Anubhav-Anand-7/Peltier-based-Liquid-Cooling-System-for-Temperature-Calibration/Photos & Videos_479_LR2C2/Image01_479_LR2C2.jpg

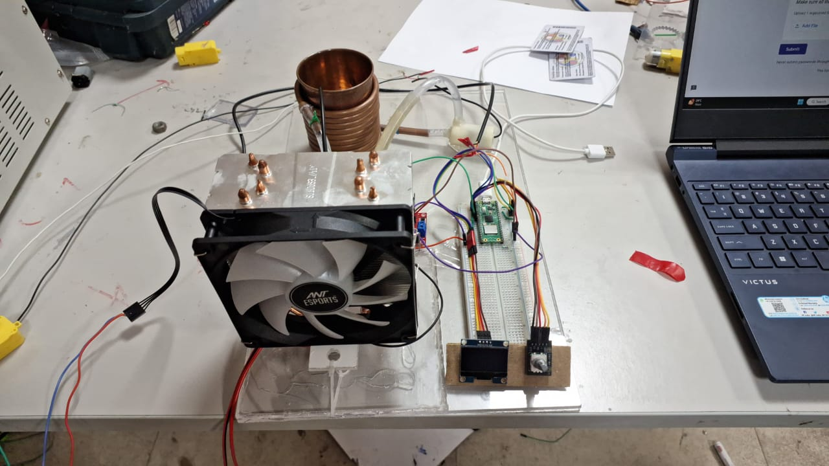
Photos & Videos_479_LR2C2/Image01_479_LR2C2.jpg
