Anubhav-Anand-7/Peltier-based-Liquid-Cooling-System-for-Temperature-Calibration/Project Plan_479_LR2C2/Resource Plan_LR2C2_479.pdf

Team ID : TW-LAM-479

479_LR2C2

Team Name : Circuit Breakers

RESOURCE | NAME | STATUS | START DATE | END DATE | DURATION
Project lead | Anubhav Anand | Complete | 17-10-2024 | 11-03-2024 | 18
Researching | Entire team | Complete | 17-10-2024 | 21-10-2024 | 5
Designer | Anurag Jayant Patil | Complete | 19-10-2024 | 21-10-2024 | 3
Procuring components | Naga Jeshwanth Sreeram | Complete | 22-10-2024 | 26-10-2024 | 5
Mechanical head | Anurag Jayant Patil | Complete | 17-10-2024 | 11-03-2024 | 18
Electronics head | Soumya Gupta | Complete | 17-10-2024 | 11-03-2024 | 18
Head coder | Soumya Gupta | Complete | 17-10-2024 | 11-03-2024 | 18
Subordinate coder | Anubhav Anand | Complete | 17-10-2024 | 11-03-2024 | 18
Circuit assembly | Anubhav Anand | Complete | 27-10-2024 | 29-10-2024 | 3
Mechanical assembly | Anurag Jayant Patil & Naga Jeshwanth Sreeram | Complete | 27-10-2024 | 29-10-2024 | 3
PID assembly | Soumya Gupta | Complete | 27-10-2024 | 29-10-2024 | 3
Testing (mechanical component) | Anurag Jayant Patil & Naga Jeshwanth Sreeram | Complete | 30-10-2024 | 02-11-2024 | 4
Testing (electronics and PID) | Anubhav Anand & Soumya Gupta | Complete | 30-10-2024 | 02-11-2024 | 4
Documentation head | Naga Jeshwanth Sreeram | Complete | 30-10-2024 | 02-11-2024 | 4
Database manager | Anubhav Anand | Complete | 17-10-2024 | 11-03-2024 | 18
Final Assembly | Entire team | Complete | 27-10-2024 | 30-10-2024 | 4

# Resource Plan
