Anubhav-Anand-7/Peltier-based-Liquid-Cooling-System-for-Temperature-Calibration/Technical Documents_LR2C2_479/BoM_479_LR2C2.pdf

Sr. No. | Item Name | Category | Quantity | Unit Cost | Total Cost | Vendor Details
1 | Peltier Module | Electronics | 1 | 250 | 250 | Bappi Electronics, Ahmed Market, Shop no C-1, Col. J Ali Road, Guwahati
2 | Temperature Sensor DS18B20 | Electronics | 1 | 250 | 250 | Bappi Electronics, Ahmed Market, Shop no C-1, Col. J Ali Road, Guwahati
3 | Submersible DC Pump | Electronics | 1 | 150 | 150 | Bappi Electronics, Ahmed Market, Shop no C-1, Col. J Ali Road, Guwahati
4 | I2C 1.30'' Oled Display | Electronics | 1 | 275 | 275 | Bappi Electronics, Ahmed Market, Shop no C-1, Col. J Ali Road, Guwahati
5 | Silicon Pipe | Mechanial | 2 | 20 | 40 | Bappi Electronics, Ahmed Market, Shop no C-1, Col. J Ali Road, Guwahati
6 | Rotory Encoder | Electronics | 1 | 200 | 200 | Bappi Electronics, Ahmed Market, Shop no C-1, Col. J Ali Road, Guwahati
7 | Copper Tumbler | Mechanial | 1 | 190 | 190 | R Campaklal(Assam) & Co, S.R.C.B Road, Fancy Bazar, Guwahati
8 | Copper Tube | Mechanial | 2.5 metre | 160 | 400 | Reetesh Trading Corporation , Police Lane,Guwahati
9 | Ant Esports ICE-C400 | Electronics | 1 | 1100 | 1100 | Bajaj Infotech, Narbada Building 2nd floor 204, KC Das Road,Guwahati
10 | Liquid Cooling Block | Mechanial | 1 | 200 | 200 | Bappi Electronics, Ahmed Market, Shop no C-1, Col. J Ali Road, Guwahati
11 | Raspberry Pi Pico W | Electronics | 1 | 600 | 600 | Bappi Electronics, Ahmed Market, Shop no C-1, Col. J Ali Road, Guwahati
12 | 12V@10A Power Supply | Electronics | 1 | 550 | 550 | Bappi Electronics, Ahmed Market, Shop no C-1, Col. J Ali Road, Guwahati
| | | Total Expenditure | | 4205

Team Name : Circuit Breakers

Team ID : TW-LAM-479
479_LR2C2

# Bill of Materials
