Anubhav-Anand-7/Peltier-based-Liquid-Cooling-System-for-Temperature-Calibration/Technical Documents_LR2C2_479/Mechanical Drawings_LR2C2_479.pdf

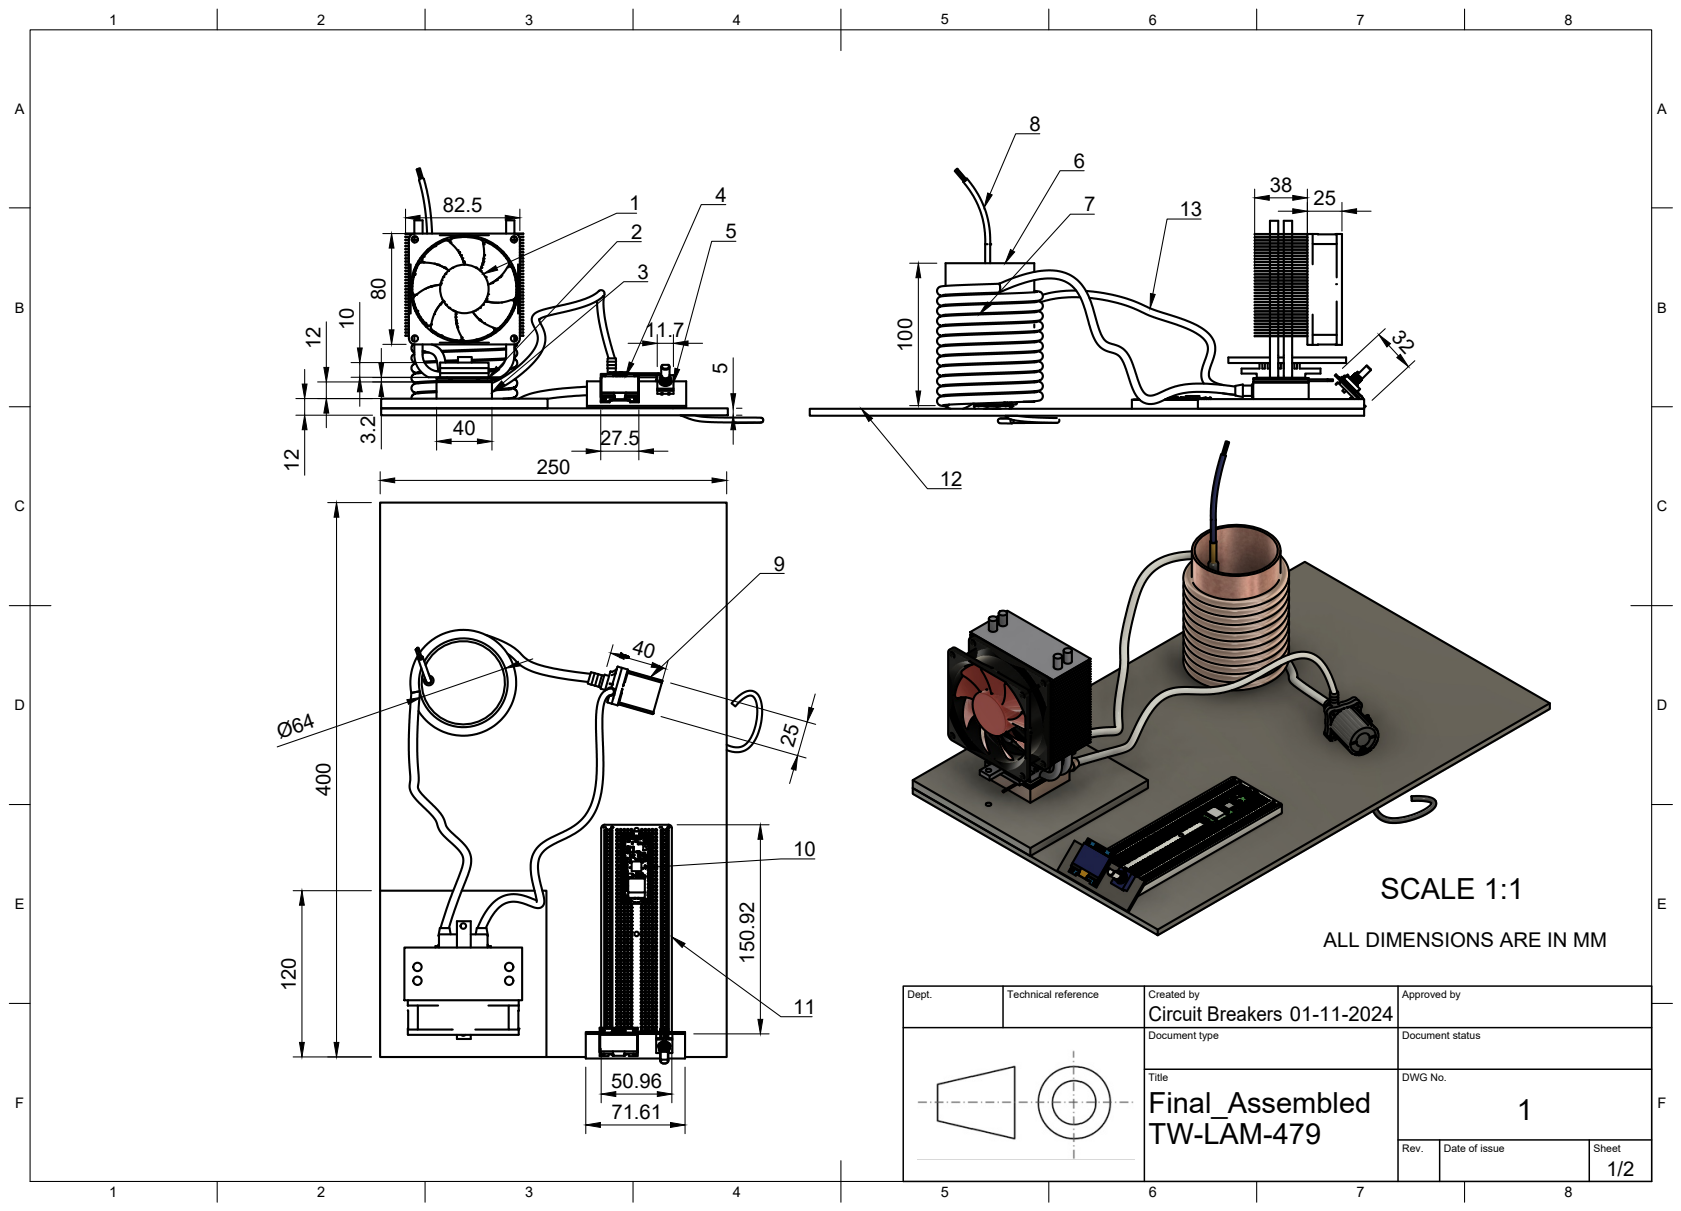
[picture p3: page 1]
Dept.; Technical reference; Created by; Approved by; Document type; Document status; Title; DWG No.; Rev.; Date of issue; Sheet; Circuit Breakers; SCALE 1:1

ALL DIMENSIONS ARE IN MM

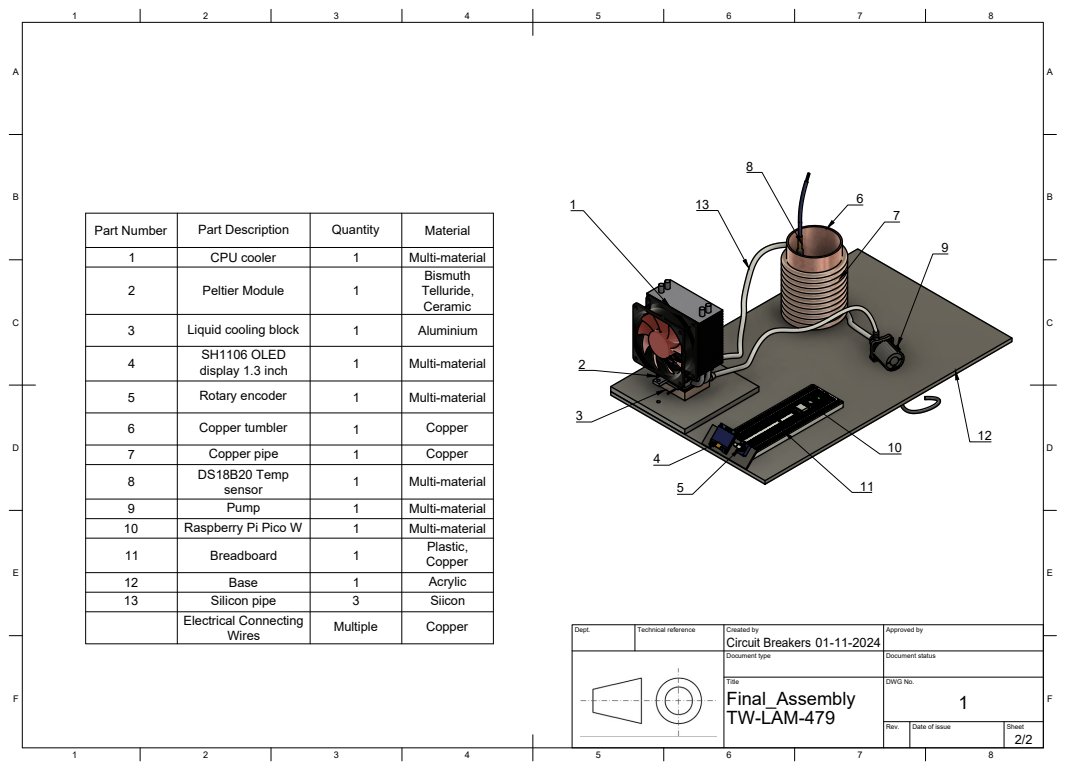
[picture p4: page 2]
Dept.; Technical reference; Created by; Approved by; Document type; Document status; Title; DWG No.; Rev.; Date of issue; Sheet; Circuit Breakers; Part Number; Part Description; Quantity; Material; CPU cooler; Multi-material; Peltier Module; Liquid cooling block; Aluminium; SH1106 OLED; display 1.3 inch; Rotary encoder; Copper tumbler; Copper; Copper pipe; DS18B20 Temp; Raspberry Pi Pico W; Silicon pipe; Siicon; Electrical Connecting
