Anubhav-Anand-7/Peltier-based-Liquid-Cooling-System-for-Temperature-Calibration/Technical Documents_LR2C2_479/Process Flow Chart_LR2C2_479.pdf

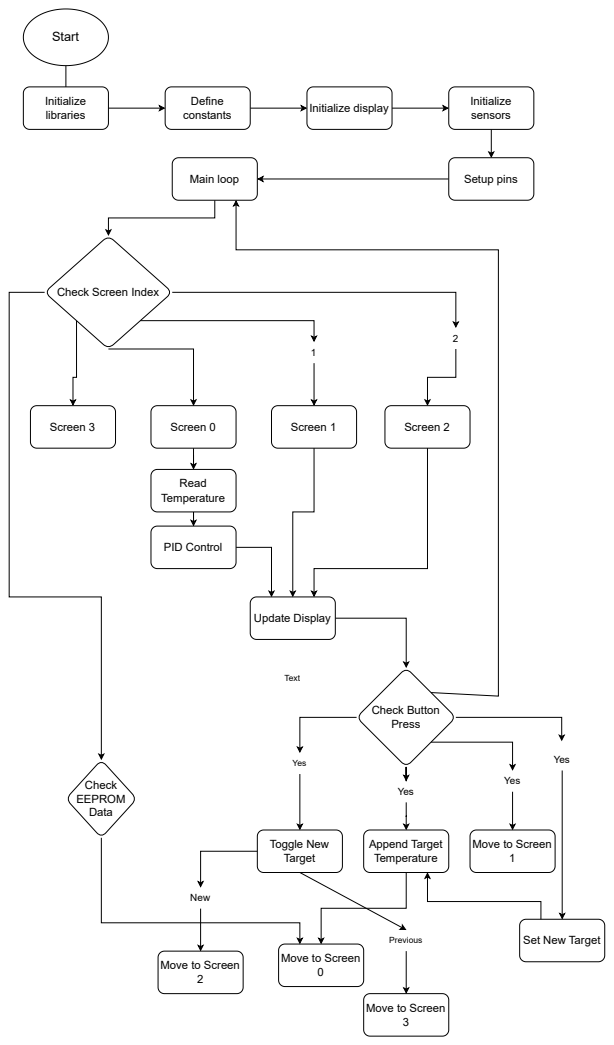
[picture p5: page 1]
Start; Initialize libraries; Define; constants; Initialize display; Initialize; sensors; Main loop; Setup pins; Screen 3; Screen 0; Screen 1; Screen 2; Read Temperature; PID Control; Update Display; Check Button Press; Append Target Temperature; Check EEPROM Data; Toggle New Target; New; Previous; Set New Target; Yes; Text

Check Screen Index

Move to Screen
