Anubhav-Anand-7/Peltier-based-Liquid-Cooling-System-for-Temperature-Calibration/Technical Documents_LR2C2_479/Wiring Diagram_LR2C2_479.pdf

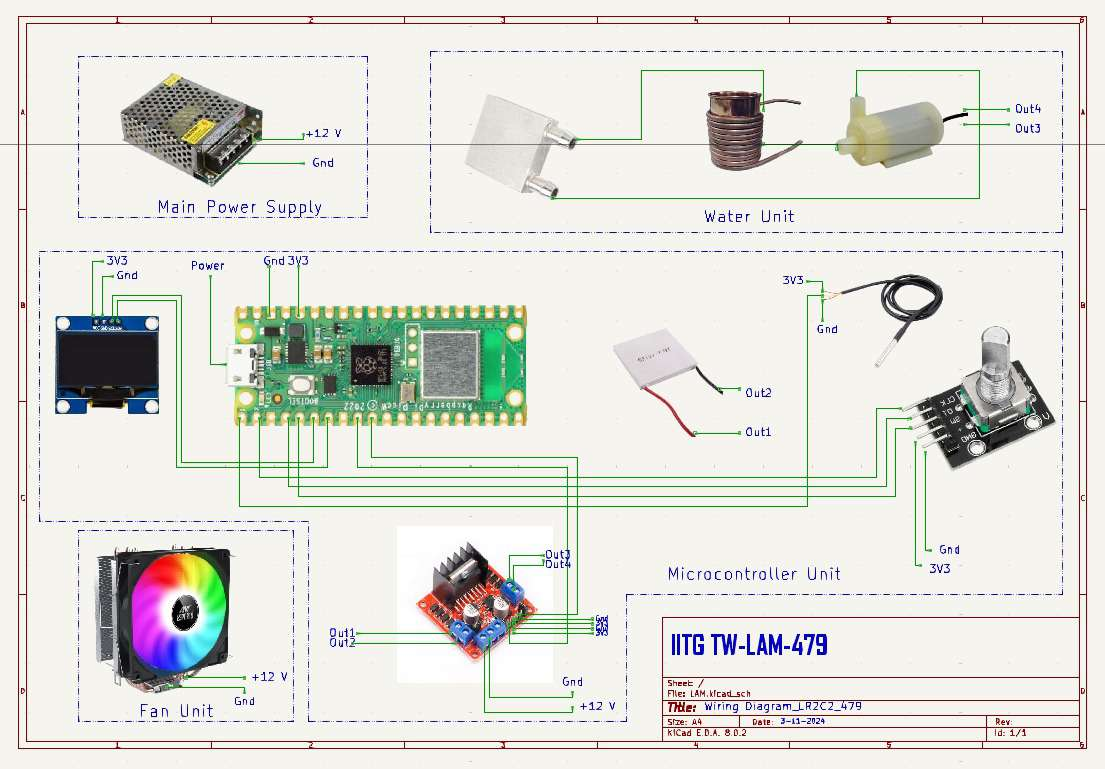
[picture p6: page 1]
